plaeyade/Zumaya-AI/fuentes/blindaje_GAMMA/ESTIMACION_BLINDAJES_ONCOLOGIA_ZUMAYA.pdf

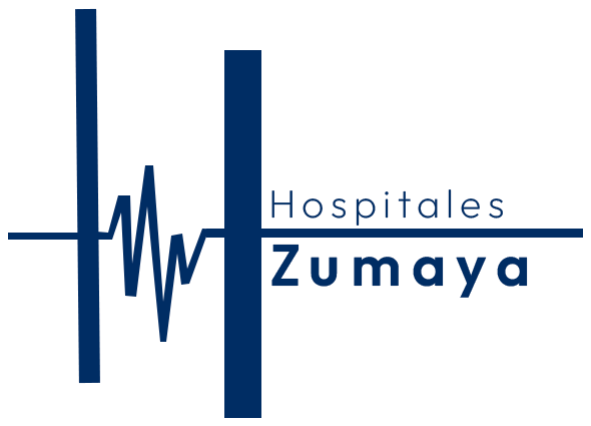
[picture p23: figure]

# ESTIMACIÓN DE BLINDAJES ONCOLOGÍA ZUMAYA

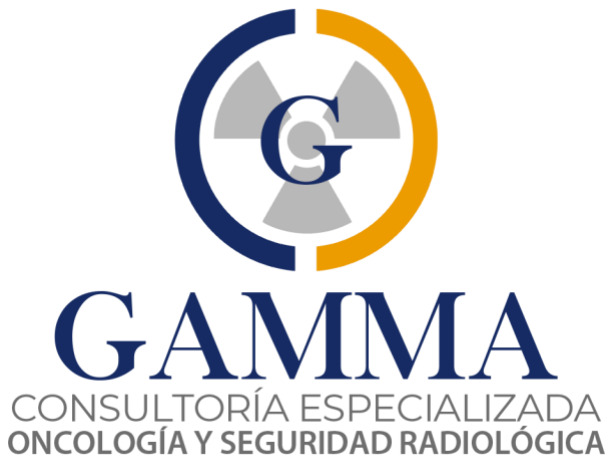
[picture p24: figure]

# HOSPITALES ZUMAYA VILLAHERMOSA

# CENTRO INTERNACIONAL DE NEURO-ONCOLOGÍA ZUMAYA

28/10/2026 LA INFORMACIÓN CONTENIDA EN ESTE DOCUMENTO ES ESTRICTAMENTE CONFIDENCIAL Y DE USO EXCLUSIVO DE GAMMA DIAGNÓSTICOS DEL SURESTE S.A. DE C.V. Y HOSPITALES ZUMAYA

# CONSIDERACIONES

- Se ha realizado un calculo estimado basado en guías y estándares internacionales utilizando un

# material de blindaje con densidad de 5.5 g/cm³

# , 5.0 g/cm³

# y 2.35 g/cm³ con el objetivo de

tener una comparación.

# - Se ha considerado la carga de trabajo máxima de los respectivos equipos contemplando el crecimiento en las mismas

- Se ha validado la propuesta de diseño del áreas, en el caso del acelerador lineal se ha dado

# prioridad a ganar espacio interno en la sala del acelerador

- Los espesores de los muros estimados en el presente documento son preliminares y el espesor final se definirá en la memoria analítica definitiva, la cual podrá presentar una variación de

# entre 15% y 20%

# Acelerador Lineal

# INFORMACIÓN DESTACADA

# - Paredes de concreto monolítico o tabiques

# - Estimaciones calculadas con densidad de 5.5 g/cm³

# , 5.0 g/cm³

# y 2.35 g/cm³

# - Criterios conservadores en los cálculos conforme a la NCRP151

# - 30 Pacientes por jornada de 8 horas

# - 2 Turnos semanales de lunes a viernes

# - 300cGy por paciente

# ECUACIONES

# - Factor de transmitancia de la barrera primaria

## - Bpri =

Pdpri

2

## WUT

# - Numero de capas decirreductoras

# - n = −log(Bpri)

# - Espesor de la barrera

# - tbarrier = TVL1 + (n − 1)TVLe

# Espesores Estimados

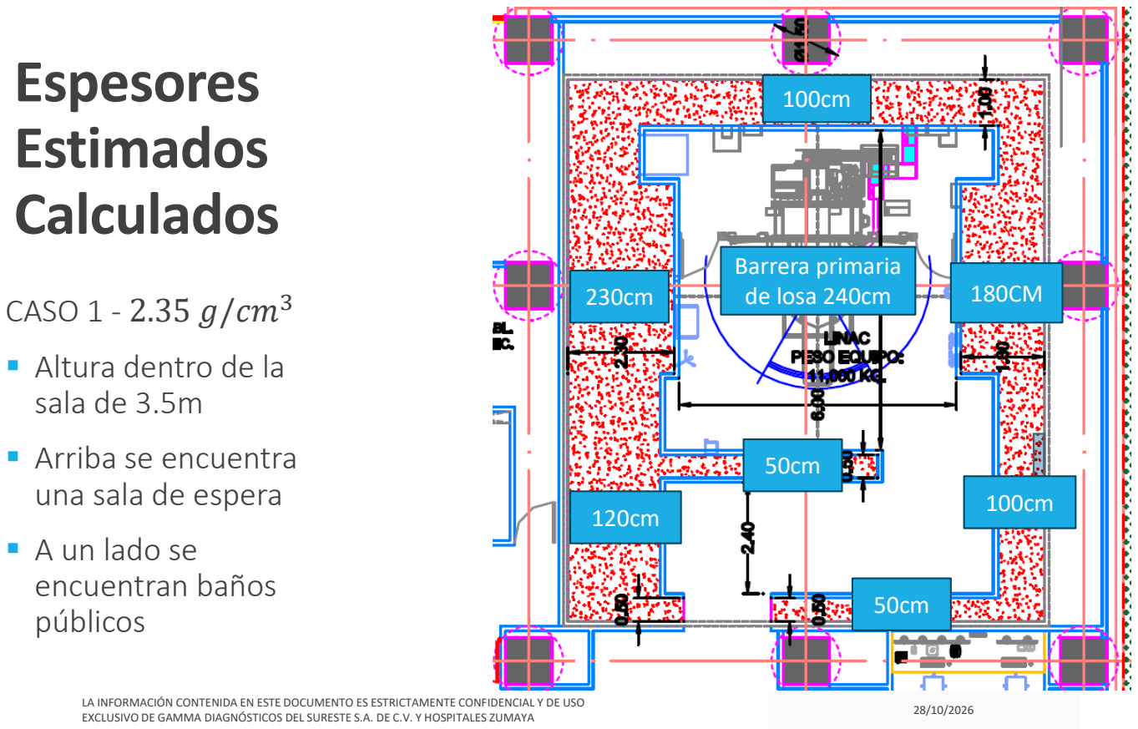
[picture p25: page 4]

# Calculados

# CASO 1 - 2.35 g/cm³

# - Altura dentro de la sala de 3.5m

# - Arriba se encuentra una sala de espera

# - A un lado se encuentran baños públicos

230cm | 180CM

# Barrera primaria de losa 240cm

100cm

50cm

50cm

120cm | 100cm

# Espesores Estimados

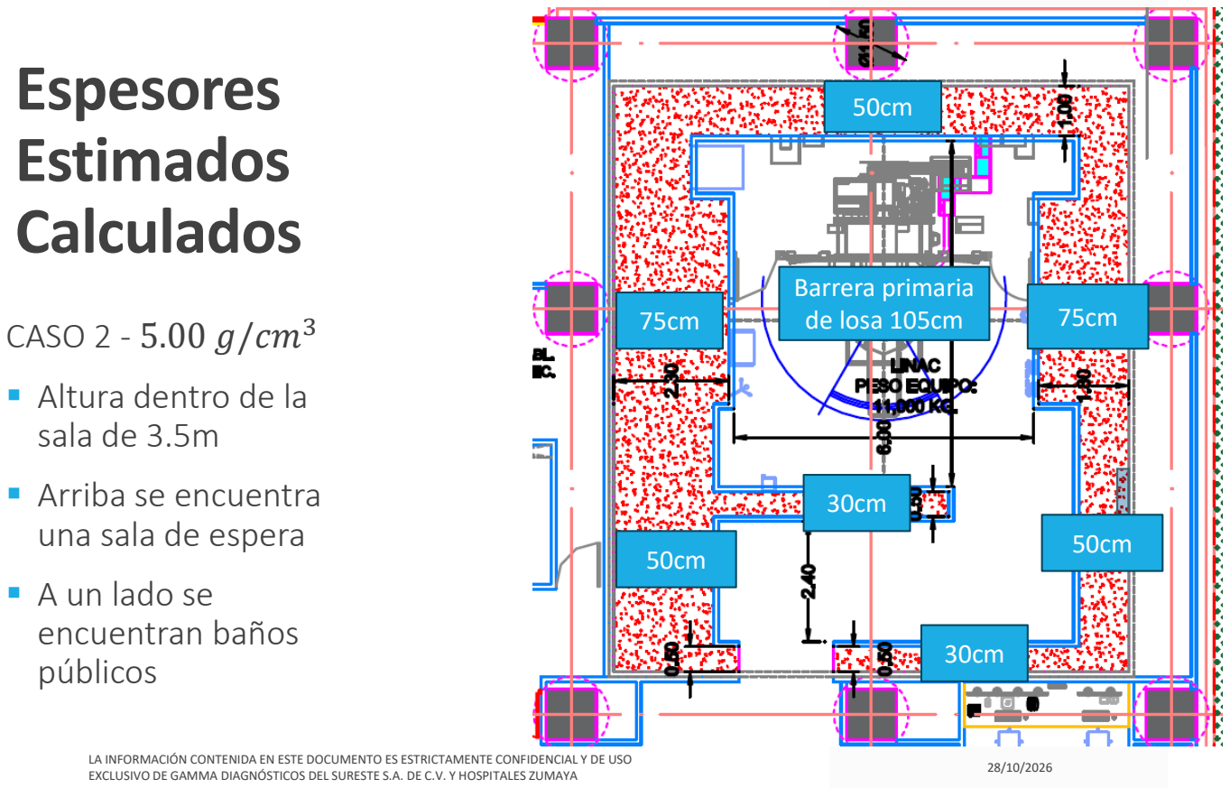
[picture p26: page 5]

# Calculados

# CASO 2 - 5.00 g/cm³

# - Altura dentro de la sala de 3.5m

# - Arriba se encuentra una sala de espera

# - A un lado se encuentran baños públicos

75cm | 75cm

# Barrera primaria de losa 105cm

50cm

30cm

30cm

50cm | 50cm

# Espesores Estimados

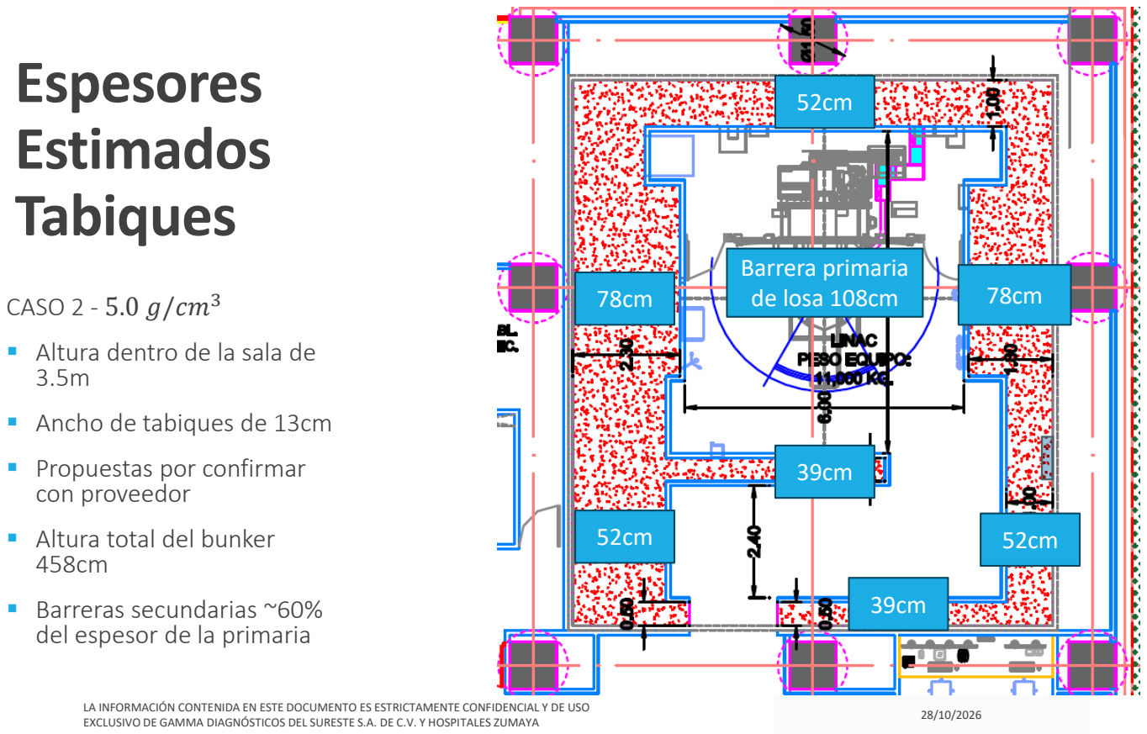
[picture p27: page 6]

# Tabiques

# CASO 2 - 5.0 g/cm³

# - Altura dentro de la sala de

3.5m

# - Ancho de tabiques de 13cm

# - Propuestas por confirmar con proveedor

# - Altura total del bunker

458cm

# - Barreras secundarias ~60% del espesor de la primaria

78cm | 78cm

# Barrera primaria de losa 108cm

52cm | 52cm

52cm

39cm

39cm

# Espesores Estimados

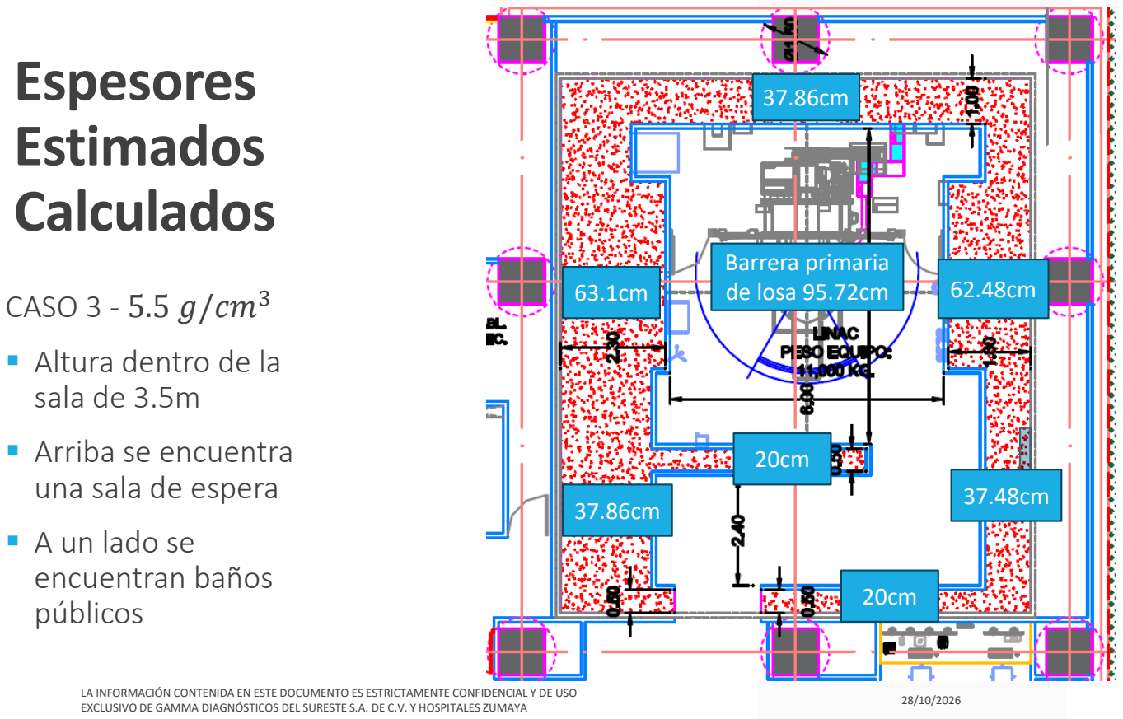
[picture p28: page 7]

# Calculados

# CASO 3 - 5.5 g/cm³

# - Altura dentro de la sala de 3.5m

# - Arriba se encuentra una sala de espera

# - A un lado se encuentran baños públicos

63.1cm | 62.48cm

# Barrera primaria de losa 95.72cm

37.86cm

20cm

20cm

37.86cm | 37.48cm

# Espesores Estimados

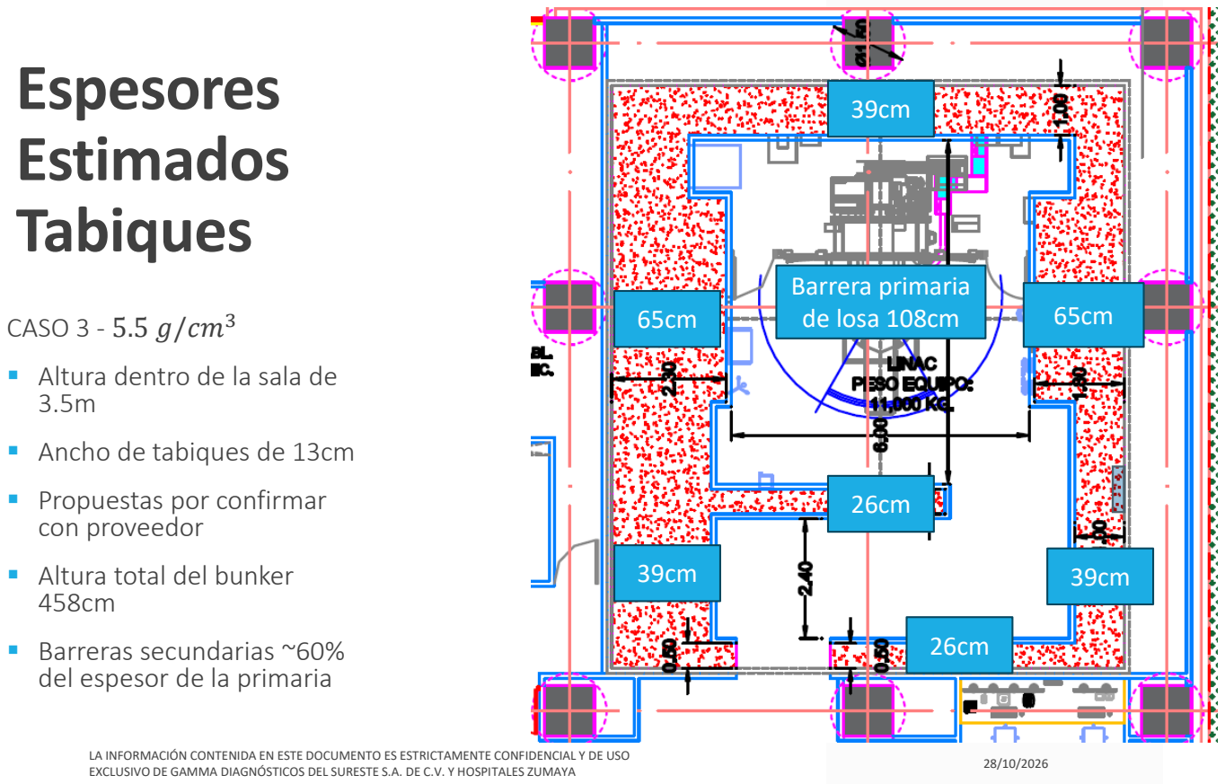
[picture p29: page 8]

# Tabiques

# CASO 3 - 5.5 g/cm³

# - Altura dentro de la sala de

3.5m

# - Ancho de tabiques de 13cm

# - Propuestas por confirmar con proveedor

# - Altura total del bunker

458cm

# - Barreras secundarias ~60% del espesor de la primaria

65cm | 65cm

# Barrera primaria de losa 108cm

39cm | 39cm

39cm

26cm

26cm

# Espesores Estimados

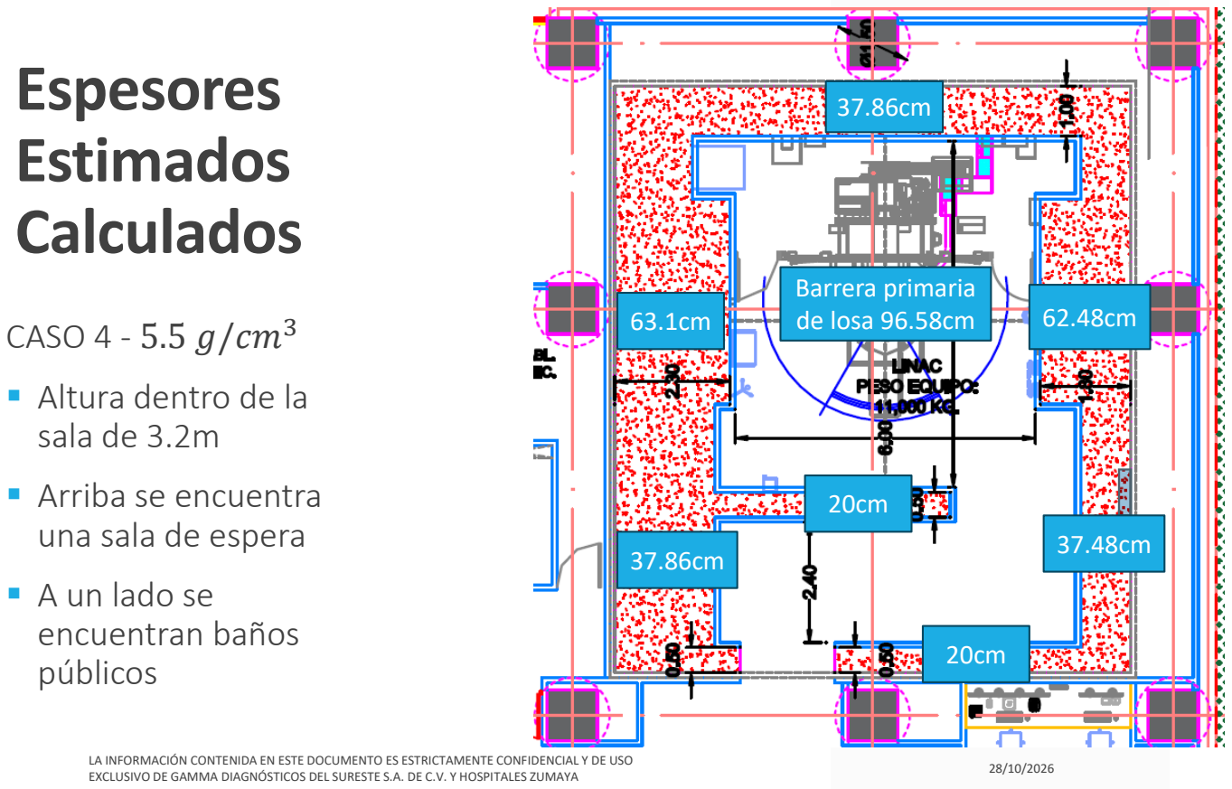
[picture p30: page 9]

# Calculados

# CASO 4 - 5.5 g/cm³

# - Altura dentro de la sala de 3.2m

# - Arriba se encuentra una sala de espera

# - A un lado se encuentran baños públicos

63.1cm | 62.48cm

# Barrera primaria de losa 96.58cm

37.86cm

20cm

20cm

37.86cm | 37.48cm

# Espesores Estimados

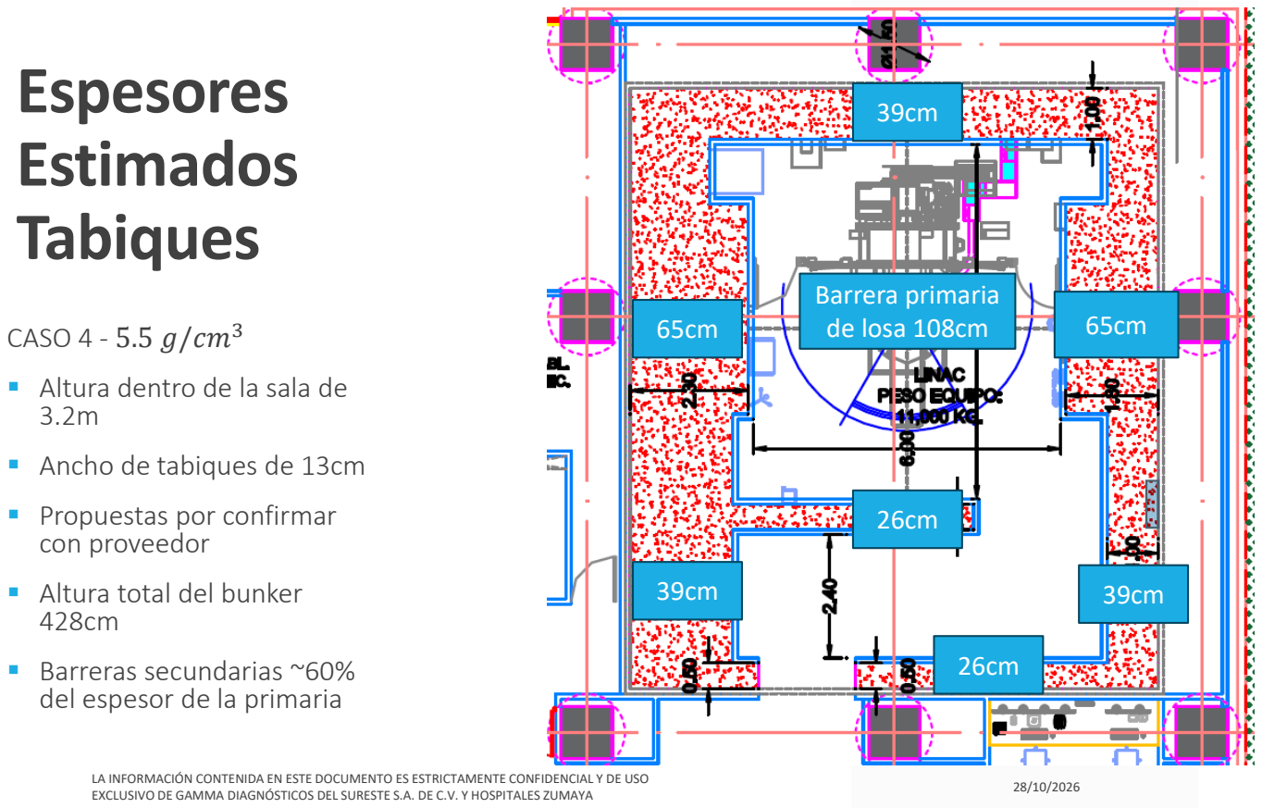
[picture p31: page 10]

# Tabiques

# CASO 4 - 5.5 g/cm³

# - Altura dentro de la sala de

3.2m

# - Ancho de tabiques de 13cm

# - Propuestas por confirmar con proveedor

# - Altura total del bunker

428cm

# - Barreras secundarias ~60% del espesor de la primaria

65cm | 65cm

# Barrera primaria de losa 108cm

39cm | 39cm

39cm

26cm

26cm

# Braquiterapia de Alta Tasa de Dosis

# INFORMACIÓN DESTACADA

# - Paredes de concreto monolítico o tabiques

# - Estimaciones calculadas con material de 3.5 g/cm³

# - Criterio restrictivo Safety Report No. 47

# - 40 ~ 50 Pacientes semanales

# - Tiempo promedio por tratamiento 25min

# - 7Gy por paciente

# ECUACIONES

# - Tasa de kerma e aire para una fuente por unidad de actividad

# - W = RAKR ∗ A ∗ t ∗ n

# - Numero de capas decirreductoras

# - No. de TVLs = −log10(

1
B

)

# - Espesor de la barrera

# - tbarrier = TVL1 + (n − 1)TVLe

# Espesores Estimados

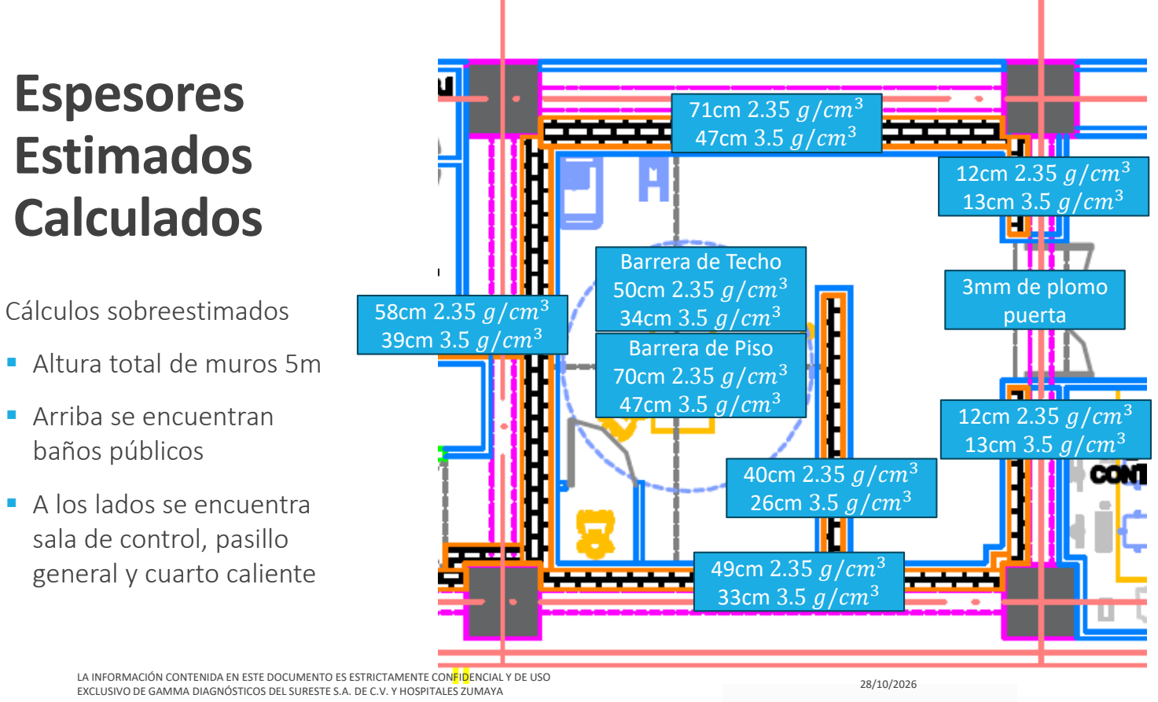
[picture p32: page 12]

# Calculados

# Cálculos sobreestimados

# - Altura total de muros 5m

# - Arriba se encuentran baños públicos

# - A los lados se encuentra sala de control, pasillo general y cuarto caliente

# 58cm 2.35 g/cm³ 39cm 3.5 g/cm³

# 3mm de plomo puerta

# 71cm 2.35 g/cm³ 47cm 3.5 g/cm³

# 49cm 2.35 g/cm³ 33cm 3.5 g/cm³

# 40cm 2.35 g/cm³ 26cm 3.5 g/cm³

# 12cm 2.35 g/cm³ 13cm 3.5 g/cm³

# Barrera de Techo 50cm 2.35 g/cm³ 34cm 3.5 g/cm³

# Barrera de Piso 70cm 2.35 g/cm³ 47cm 3.5 g/cm³

# 12cm 2.35 g/cm³ 13cm 3.5 g/cm³

# Espesores Estimados

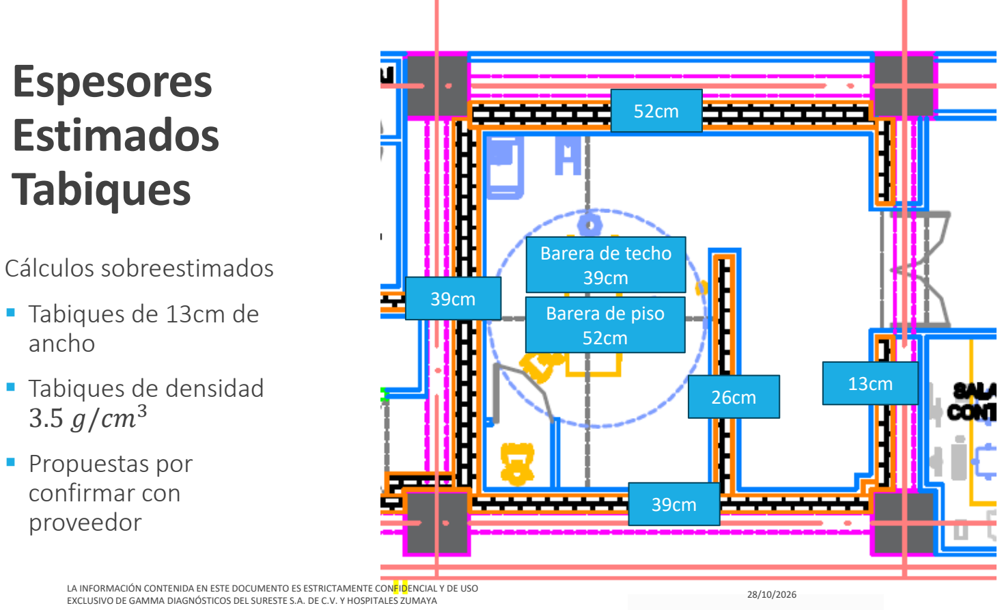
[picture p33: page 13]

# Tabiques

# Cálculos sobreestimados

# - Tabiques de 13cm de ancho

# - Tabiques de densidad 3.5 g/cm³

# - Propuestas por confirmar con proveedor

39cm

52cm

26cm

13cm

39cm

# Barera de techo

39cm

# Barera de piso

52cm

# Gamma Knife

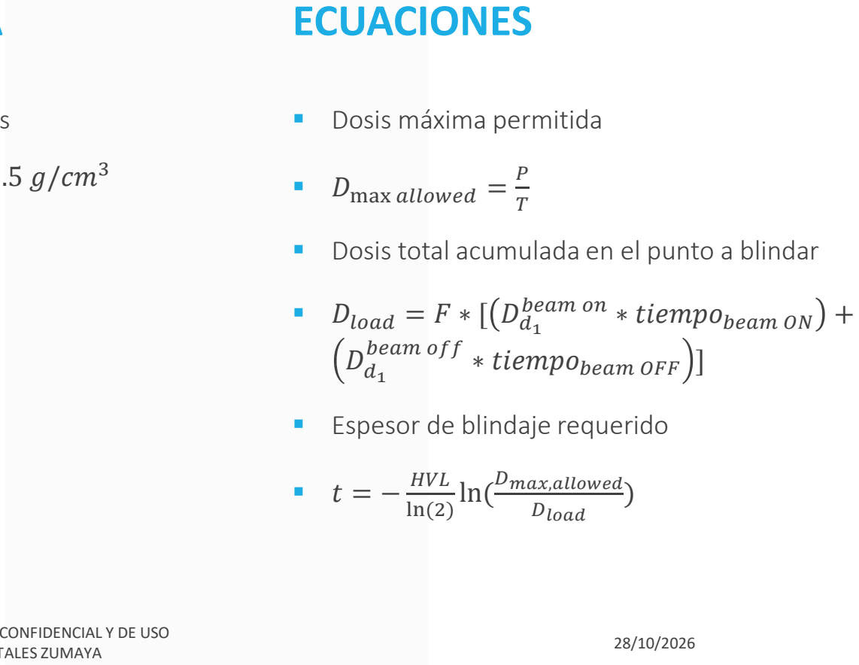
[picture p34: figure]
ECUACIONES; ▪ Dosis máxima permitida; ▪ Dmax allowed =; ▪ Dload = F ∗ [ Dd1; beam on ∗ tiempobeam ON +; beam off; ∗ tiempobeam OFF ]; ▪ Espesor de blindaje requerido; HVL ln(2); Dmax,allowed; Dload

# INFORMACIÓN DESTACADA

## - Paredes de concreto monolítico o tabiques

## - Estimaciones calculadas con material de 3.5 g/cm³

## - Criterio restrictivo ICRP

## - 20 Pacientes semanales

## - 5 días a la semana

## - Actividad máxima de 6600Ci +10%

## - Dosis total acumulada en el punto a blindar

# Espesores Estimados

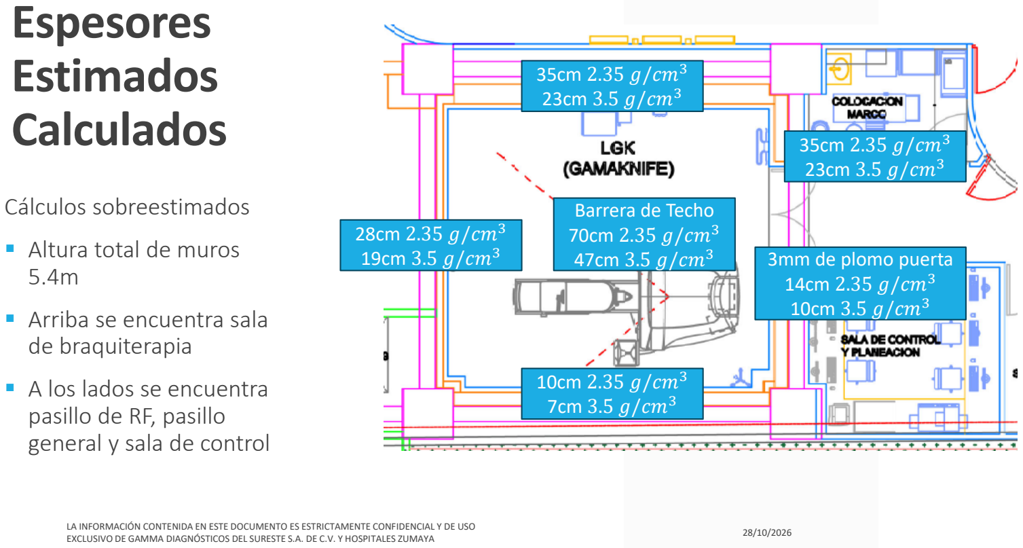
[picture p35: page 15]

# Calculados

# Cálculos sobreestimados

# - Altura total de muros

5.4m

# - Arriba se encuentra sala de braquiterapia

# - A los lados se encuentra pasillo de RF, pasillo general y sala de control

# 28cm 2.35 g/cm³ 19cm 3.5 g/cm³

# 10cm 2.35 g/cm³ 7cm 3.5 g/cm³

# 35cm 2.35 g/cm³ 23cm 3.5 g/cm³

# 3mm de plomo puerta 14cm 2.35 g/cm³ 10cm 3.5 g/cm³

# Barrera de Techo 70cm 2.35 g/cm³ 47cm 3.5 g/cm³

# 35cm 2.35 g/cm³ 23cm 3.5 g/cm³

# PET/CT

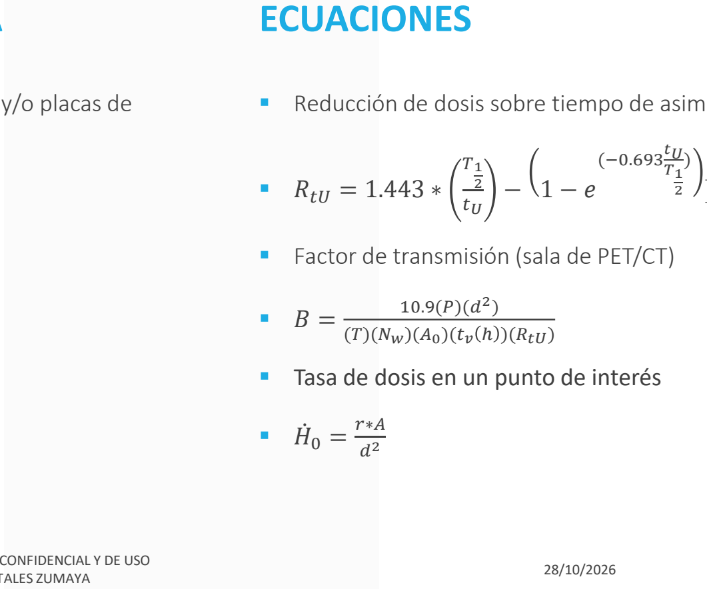
[picture p36: figure]
ECUACIONES; ▪ RtU = 1.443 ∗; (T)(Nw)(A0)(tv ℎ )(RtU); ▪ Tasa de dosis en un punto de interés

# INFORMACIÓN DESTACADA

## - Paredes de concreto monolítico, tabiques y/o placas de plomo

## - Criterio restrictivo AAPM Task Group 108

## - 60 Pacientes por semana, 2 turnos al día

## - 5 días a la semana

## - Actividad por paciente de 20mCi

## - Reducción de dosis sobre tiempo de asimilación de dosis

]

## - Factor de transmisión (sala de PET/CT)

# Espesores Estimados

# Cálculos sobreestimados - Altura de entrepiso 5m - Arriba se encuentra Medicina Nuclear - A los lados se encuentra sala de control y salas de inyección - Solo es necesario blindar hasta 2.5m de altura

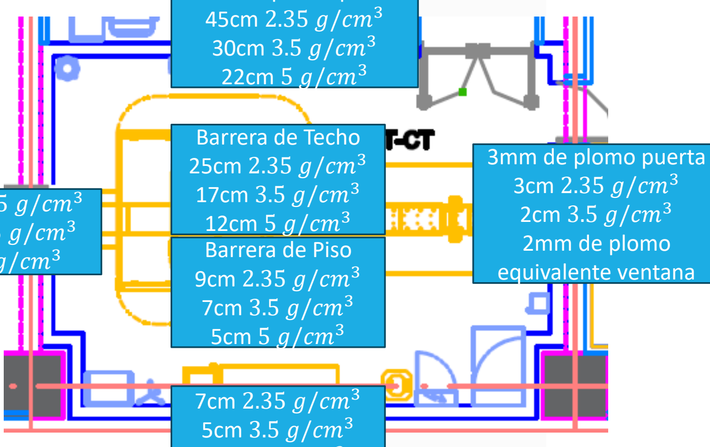
[picture p37: figure]
45cm 2.35 g/cm³ 30cm 3.5 g/cm³ 22cm 5 g/cm³; 3mm de plomo puerta 3cm 2.35 g/cm³ 2cm 3.5 g/cm³ 2mm de plomo equivalente ventana; 7cm 2.35 g/cm³ 5cm 3.5 g/cm³

# 15cm 2.35 g/cm³ 10cm 3.5 g/cm³ 7cm 5 g/cm³

# 3mm de plomo puerta

# Barrera de Techo 25cm 2.35 g/cm³ 17cm 3.5 g/cm³ 12cm 5 g/cm³

# Barrera de Piso 9cm 2.35 g/cm³ 7cm 3.5 g/cm³ 5cm 5 g/cm³

# 4cm 5 g/cm³

# Espesores

# Barrera de Techo

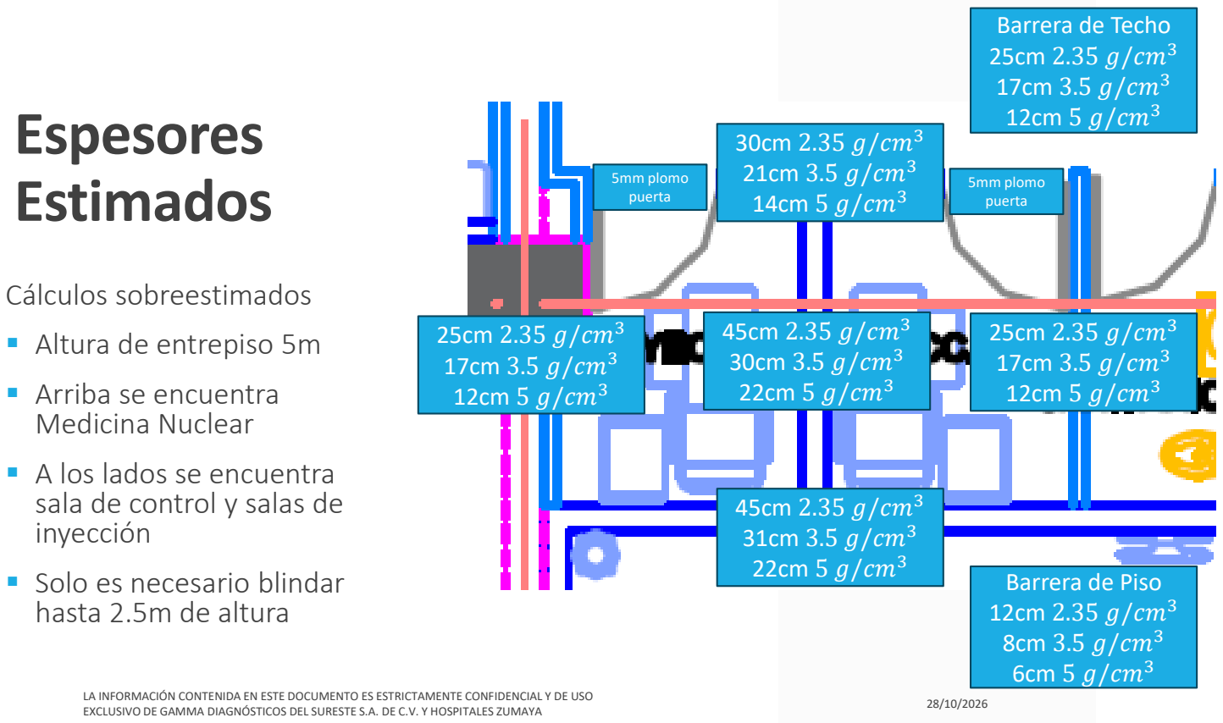
[picture p38: page 18]

# Estimados

# Cálculos sobreestimados - Altura de entrepiso 5m - Arriba se encuentra Medicina Nuclear - A los lados se encuentra sala de control y salas de inyección - Solo es necesario blindar hasta 2.5m de altura

### 5mm plomo puerta

# 25cm 2.35 g/cm³ 17cm 3.5 g/cm³ 12cm 5 g/cm³

# 25cm 2.35 g/cm³ 17cm 3.5 g/cm³ 12cm 5 g/cm³

# 45cm 2.35 g/cm³ 30cm 3.5 g/cm³ 22cm 5 g/cm³

# 25cm 2.35 g/cm³ 17cm 3.5 g/cm³ 12cm 5 g/cm³

# 30cm 2.35 g/cm³ 21cm 3.5 g/cm³ 14cm 5 g/cm³

### 5mm plomo puerta

# Barrera de Piso 12cm 2.35 g/cm³ 8cm 3.5 g/cm³ 6cm 5 g/cm³

# 45cm 2.35 g/cm³ 31cm 3.5 g/cm³ 22cm 5 g/cm³

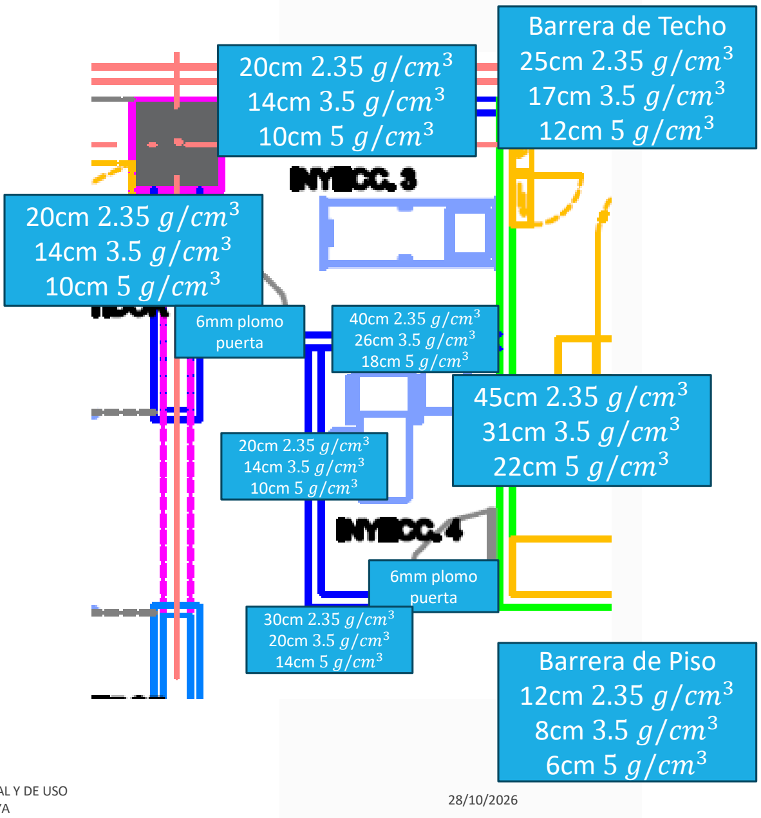
[picture p39: figure]
20cm 2.35 g/cm³ 14cm 3.5 g/cm³ 10cm 5 g/cm³; Barrera de Techo 25cm 2.35 g/cm³ 17cm 3.5 g/cm³ 12cm 5 g/cm³; 6mm plomo puerta; Barrera de Piso 12cm 2.35 g/cm³ 8cm 3.5 g/cm³ 6cm 5 g/cm³; 40cm 2.35 g/cm³ 26cm 3.5 g/cm³ 18cm 5 g/cm³; 30cm 2.35 g/cm³ 20cm 3.5 g/cm³ 14cm 5 g/cm³; 45cm 2.35 g/cm³ 31cm 3.5 g/cm³ 22cm 5 g/cm³

# Espesores Estimados

# Cálculos sobreestimados - Altura de entrepiso 5m - Arriba se encuentra Medicina Nuclear - A los lados se encuentra sala de control y salas de inyección - Solo es necesario blindar hasta 2.5m de altura

# Espesores

# CASTILLO DE 5CM DE

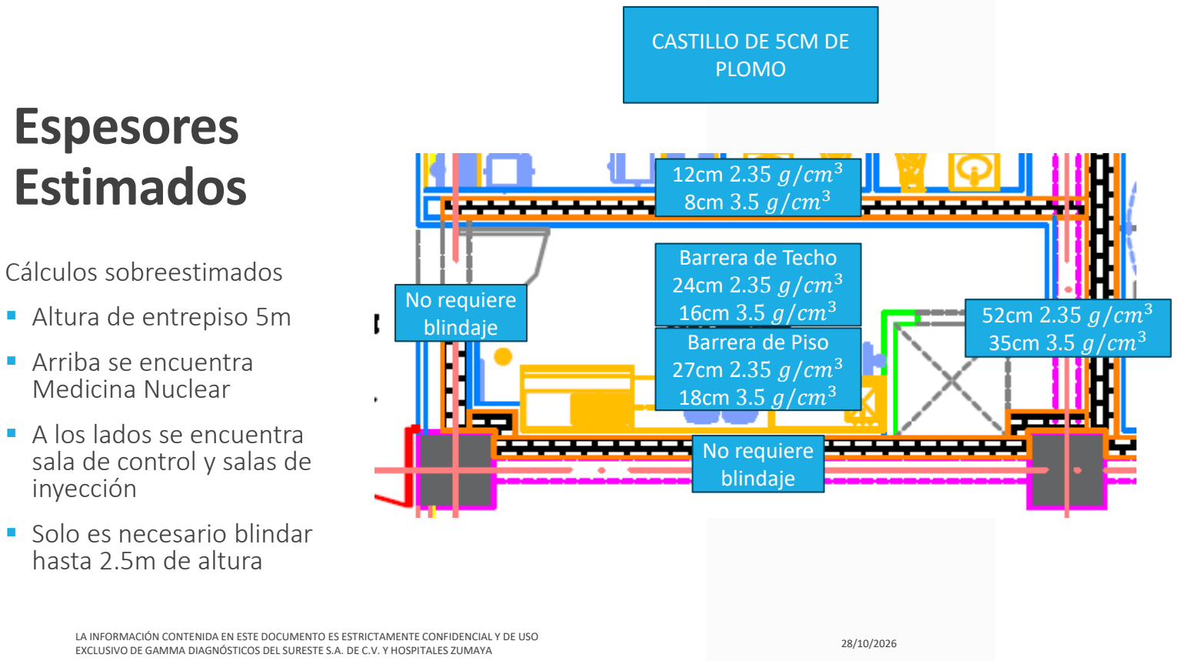
[picture p40: page 20]

# Estimados

# Cálculos sobreestimados - Altura de entrepiso 5m - Arriba se encuentra Medicina Nuclear - A los lados se encuentra sala de control y salas de inyección - Solo es necesario blindar hasta 2.5m de altura

# No requiere blindaje

# PLOMO

# 12cm 2.35 g/cm³ 8cm 3.5 g/cm³

# Barrera de Techo 24cm 2.35 g/cm³ 16cm 3.5 g/cm³

# Barrera de Piso 27cm 2.35 g/cm³ 18cm 3.5 g/cm³

# No requiere

blindaje | 52cm 2.35 g/cm³
| 35cm 3.5 g/cm³

# SPECT/CT

# INFORMACIÓN DESTACADA

## - Paredes de concreto monolítico, tabiques y/o placas de plomo

## - Criterio restrictivo IAEA-TECODC-1608

## - 40 Pacientes por semana Tc99, 2 pacientes de I131, 1 paciente de Lu-177

## - 5 días a la semana

## - Actividad variable por paciente y por estudio, se consideran los tiempos de estancia variables por isotopo

# ECUACIONES

## - Reducción de dosis sobre tiempo de asimilación de dosis

## - RtU = 1.443 ∗

T1
2
tU

− 1 − e

(−0.693tU
T1
2

)
]

## - Factor de transmisión

- B =

P

### ሶ Hሶ

0

## - Tasa equivalente de dosis con blindaje

- Hሶ

## f = Hሶ

0e

−μx

# Espesores

# 2mm Plomo

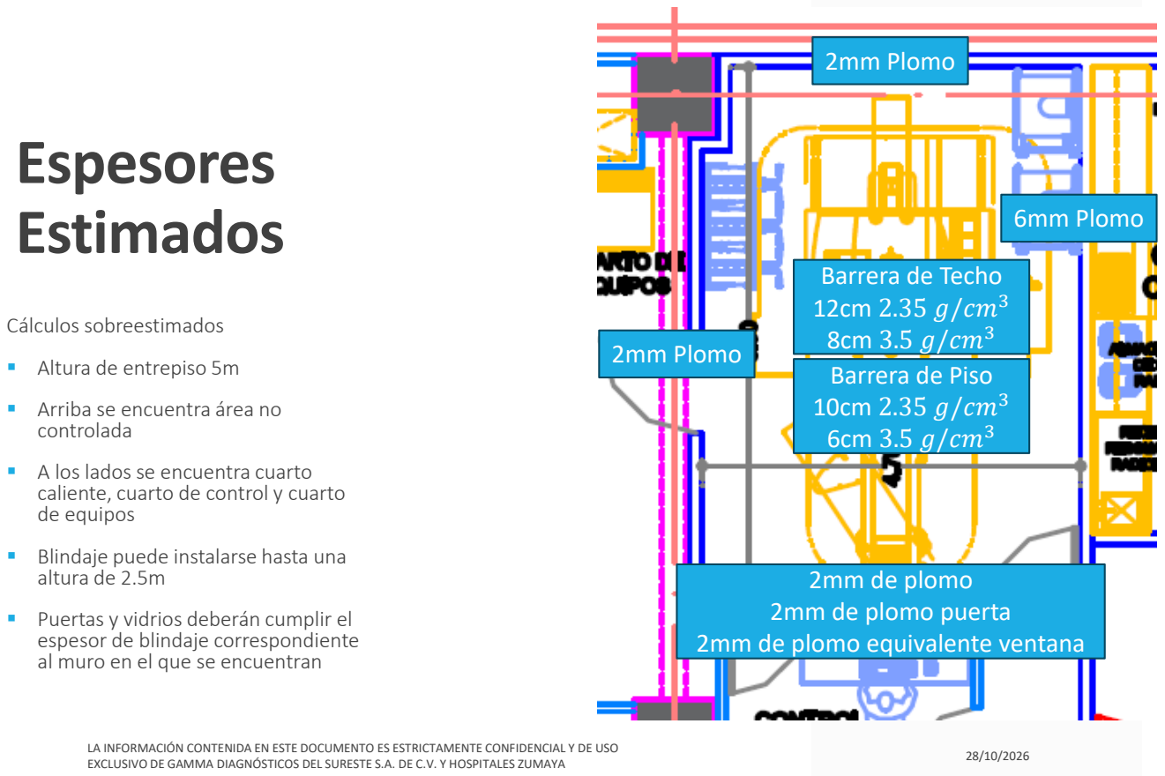
[picture p41: page 22]

# Estimados

## Cálculos sobreestimados

## - Altura de entrepiso 5m

## - Arriba se encuentra área no controlada

## - A los lados se encuentra cuarto caliente, cuarto de control y cuarto de equipos

## - Blindaje puede instalarse hasta una altura de 2.5m

## - Puertas y vidrios deberán cumplir el espesor de blindaje correspondiente al muro en el que se encuentran

# 2mm Plomo

# Barrera de Techo 12cm 2.35 g/cm³ 8cm 3.5 g/cm³

# Barrera de Piso 10cm 2.35 g/cm³ 6cm 3.5 g/cm³

# 6mm Plomo

# 2mm de plomo 2mm de plomo puerta 2mm de plomo equivalente ventana

# Espesores Estimados

## Cálculos sobreestimados

## - Altura de entrepiso 5m

## - Arriba se encuentra área no controlada

## - A los lados se encuentra cuarto caliente, cuarto de control y cuarto de equipos

## - Blindaje puede instalarse hasta una altura de 2.5m

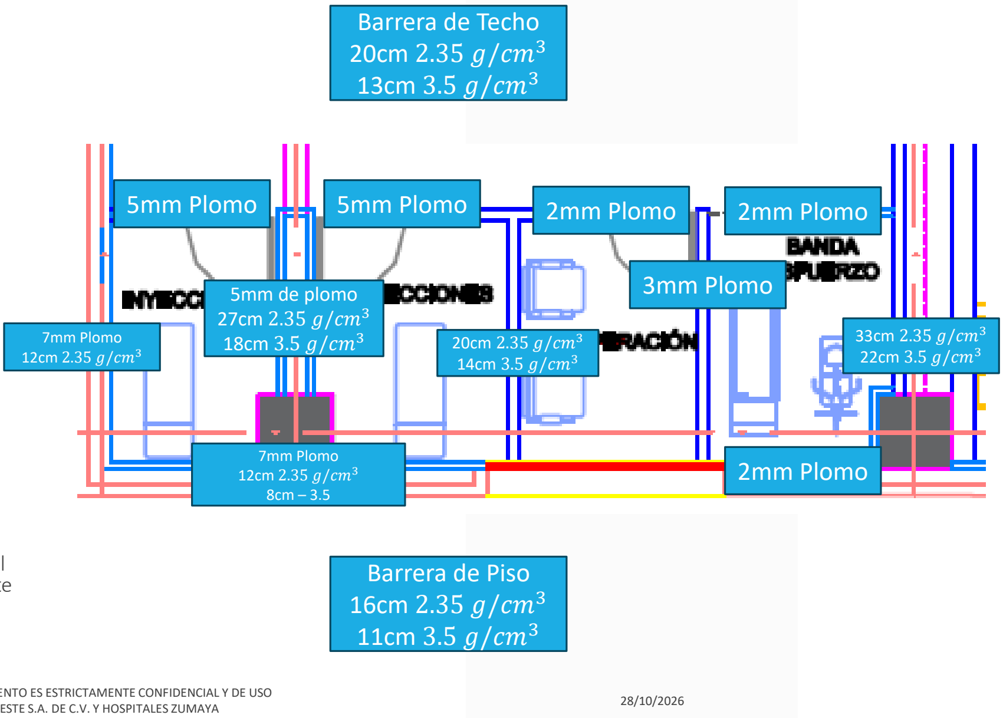
[picture p42: figure]
7mm Plomo 12cm 2.35 g/cm³; 7mm Plomo 12cm 2.35 g/cm³ 8cm – 3.5; 20cm 2.35 g/cm³ 14cm 3.5 g/cm³; Barrera de Techo 20cm 2.35 g/cm³ 13cm 3.5 g/cm³; Barrera de Piso 16cm 2.35 g/cm³ 11cm 3.5 g/cm³; 5mm de plomo 27cm 2.35 g/cm³ 18cm 3.5 g/cm³; 2mm Plomo; 3mm Plomo; 33cm 2.35 g/cm³ 22cm 3.5 g/cm³; 5mm Plomo

## - Puertas y vidrios deberán cumplir el espesor de blindaje correspondiente al muro en el que se encuentran

# Espesores

# Pendiente calculo de

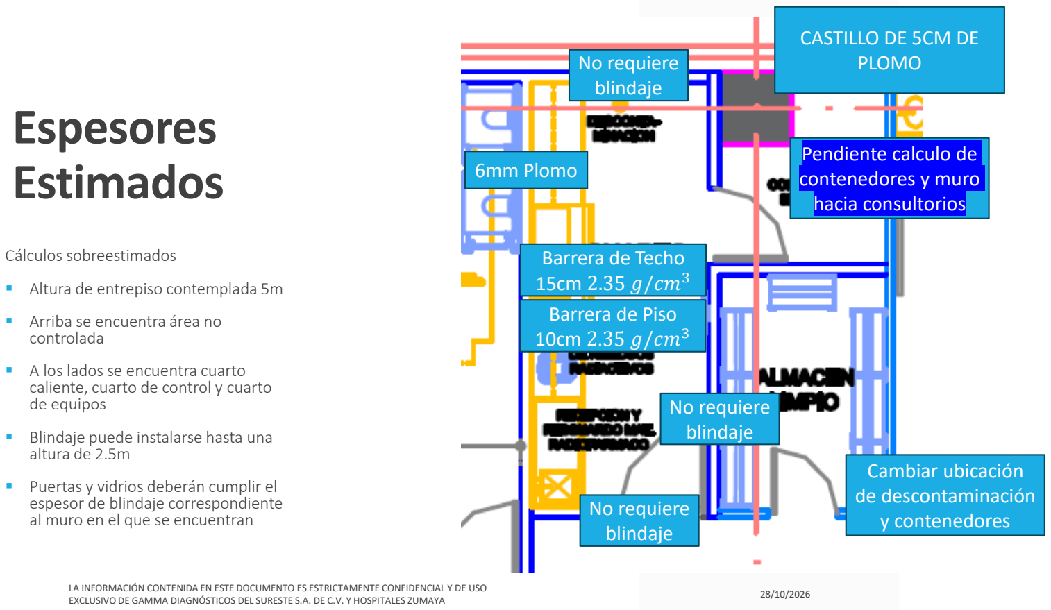
[picture p43: page 24]

# Estimados

## Cálculos sobreestimados

## - Altura de entrepiso contemplada 5m

## - Arriba se encuentra área no controlada

## - A los lados se encuentra cuarto caliente, cuarto de control y cuarto de equipos

## - Blindaje puede instalarse hasta una altura de 2.5m

## - Puertas y vidrios deberán cumplir el espesor de blindaje correspondiente al muro en el que se encuentran

# Cambiar ubicación de descontaminación y contenedores

# contenedores y muro hacia consultorios

# Barrera de Techo 15cm 2.35 g/cm³

# CASTILLO DE 5CM DE

No requiere | PLOMO

# blindaje

# No requiere blindaje

# No requiere blindaje

# Barrera de Piso 10cm 2.35 g/cm³

# 6mm Plomo

# Medicina Nuclear

# INFORMACIÓN DESTACADA

## - Paredes de concreto monolítico, tabiques y/o placas de plomo

## - Criterio restrictivo IAEA-TECODC-1608

## - Carga máxima semanal de 2 pacientes cada uno 3 días hospitalizado

## - Dosis máxima administrada de 200mCi de I131

# ECUACIONES

## - Reducción de dosis sobre tiempo de asimilación de dosis

## - RtU = 1.443 ∗

T1
2
tU

− 1 − e

(−0.693tU
T1
2

)
]

## - Factor de transmisión

- B =

P

### ሶ Hሶ

0

## - Tasa equivalente de dosis con blindaje

- Hሶ

## f = Hሶ

0e

−μx

# Espesores

# 27cm 2.35 g/cm³

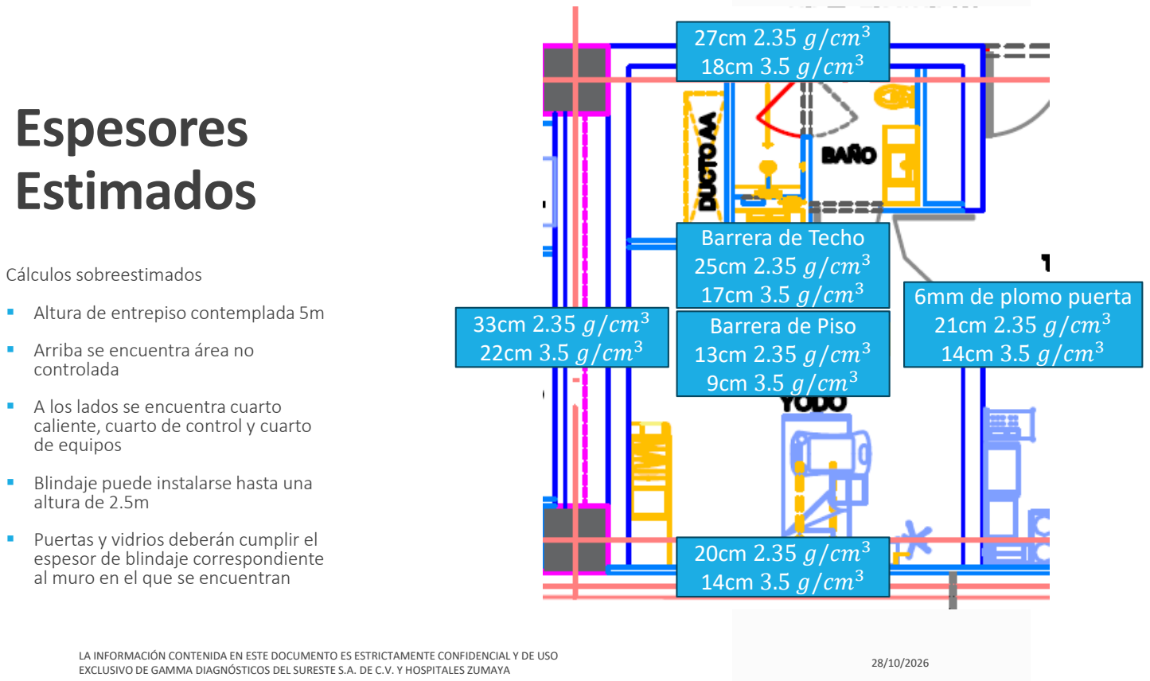
[picture p44: page 26]

# Estimados

## Cálculos sobreestimados

## - Altura de entrepiso contemplada 5m

## - Arriba se encuentra área no controlada

## - A los lados se encuentra cuarto caliente, cuarto de control y cuarto de equipos

## - Blindaje puede instalarse hasta una altura de 2.5m

## - Puertas y vidrios deberán cumplir el espesor de blindaje correspondiente al muro en el que se encuentran

# 33cm 2.35 g/cm³ 22cm 3.5 g/cm³

# Barrera de Techo 25cm 2.35 g/cm³ 17cm 3.5 g/cm³

# Barrera de Piso 13cm 2.35 g/cm³ 9cm 3.5 g/cm³

# 20cm 2.35 g/cm³ 14cm 3.5 g/cm³

# 18cm 3.5 g/cm³

# 6mm de plomo puerta 21cm 2.35 g/cm³ 14cm 3.5 g/cm³
