plaeyade/Zumaya-AI/informes/Seguimiento_Zumaya_31-10-26.xlsx

Sheet: Pasos Claude
Próximos pasos — ciclotrón Zumaya (31/10/2026)
Estado en amarillo: elige de la lista. Estimado total 1–2 h, según los lotes del Monte Carlo.
# | Paso | Detalle | Depende de | Estado
1 | Terminar lotes MC doble haz | Techo (2 lotes), sur (1) y oeste (2); muro este ya validado: 2.08 m de tabique 2.5 | Cómputo en curso | En curso
2 | Espesores por cara | Techo, oeste y sur con doble haz 2×150 µA, concreto 2.35 → tabique 2.5 por masa | Paso 1 | Pendiente
3 | Informe Zumaya | Completar secciones de validación contra IBA tabla 9 y doble haz | Paso 2 | Pendiente
4 | Bajada de cargas | Recalcular peso del búnker y pilas con los espesores nuevos | Paso 2 | Pendiente
5 | PDF y repos | Exportar PDF nuevo; subir a Zumaya-AI y Cyclotron-SIM | Pasos 3–4 | Pendiente
Avance | 0 de 5

Sheet: Datos pendientes
Datos que dependen de ti
Ordenados por impacto. Responsable y fecha: llénalos tú (ejemplo en la fila 1).
# | Dato | Para qué | Impacto | Responsable | Fecha compromiso | Estado
1 | Análisis químico del TD-250 | Repetir el MC del ciclotrón con el hidrógeno real (mientras: dos hipótesis, 1 % y 0.4 % H) | Alto | Proveedor CONTUPLEX |  | En proceso
2 | Pesaje de 5–10 piezas TD-550 | Saber si el linac necesita 1–2 o 3–4 tabiques más por muro (23.6 kg = 5.5; 18.4 kg = 4.29) | Alto
3 | Actividad real Co-60 Flexitron + geometría de su puerta | La puerta de GAMMA (3 mm Pb) casi no atenúa Co-60 | Alto
4 | Geometría de puerta y laberinto del linac | Fotoneutrones y gammas de captura a 15 MV | Alto
5 | Documentos IBA pendientes | Reporte de blindaje MC estándar/personalizado y asignación de blancos por puerto | Medio
6 | Layout de radiofarmacia | Celdas calientes, líneas de transferencia y su paso bajo el contraventeo NA | Medio
Avance | 0 de 6

Sheet: Decisiones
Decisiones tuyas
Marca la decisión en la columna Estado.
# | Decisión | Qué implica | Esfuerzo | Estado
1 | Combinar el PR de radiopharma-os | F81–F85 + F90 (contrato con Cyclotron-SIM y presupuesto de blindaje) a master | Revisión | Pendiente
2 | Arrancar etapa 0 de RadShieldMx | Rama aparte: quitar diálogos con resultados aleatorios, leyenda 'no válido para firma', lockfile contra npmjs, quitar aval institucional falso. No cambia el cálculo | 1 semana | Pendiente
3 | Acelerar el MC del ciclotrón | Agregar ventanas de peso para corridas más rápidas y estables (TD-250 real, otras máquinas) | 1–2 días | Pendiente
Avance | 0 de 3
