plaeyade/Zumaya-AI/informes/Linac_TD550_cumplimiento.xlsx

Sheet: Supuestos
Supuestos — linac Versa HD 15 MV, tabique TD-550 (CONTUPLEX)
Celdas en azul = entradas editables; amarillo = la incógnita que se resuelve pesando piezas en obra.
Parámetro | Valor | Unidad | Origen
Carga de trabajo W | 900 | Gy/sem | 30 pac × 2 turnos × 5 d × 3 Gy (estimación GAMMA, NCRP 151)
Límite de diseño P (público) | 2e-05 | Sv/sem | 0.02 mSv/sem (NCRP 151)
Fracción de fuga (90°) | 0.001 | — | NCRP 151: 0.1 % del haz útil
Módulo de tabique | 13 | cm | pieza 130 mm
TVL primaria TD-550, ficha (15 MV) | 18.2 | cm | ficha CONTUPLEX TD-550 (escalada por densidad nominal 5.5)
TVL fuga TD-550, ficha (15 MV) | 17.1 | cm | ficha CONTUPLEX TD-550
TVL primaria TD-350 medida (15 MV) | 28.7 | cm | ficha TD-350 (6/10 MV medidas; 15 MV interpolada)
TVL fuga TD-350 (15 MV) | 26.8 | cm | ficha TD-350
Densidad real TD-350 | 3.317 | g/cm³ | IMCYC OT-521, masa específica seca
Densidad real TD-550 (si no es 5.5) | 4.29 | g/cm³ | estimada 5.5 × (seca/aparente del '5' IMCYC) — sin ensaye
TVL primaria TD-550 con densidad real | 22.2 | cm | TVL TD-350 × ρ350 / ρ550 real
TVL fuga TD-550 con densidad real | 20.7 | cm | TVL TD-350 × ρ350 / ρ550 real
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
