plaeyade/Zumaya-AI/analisis_plano/losas_ciclotron.png

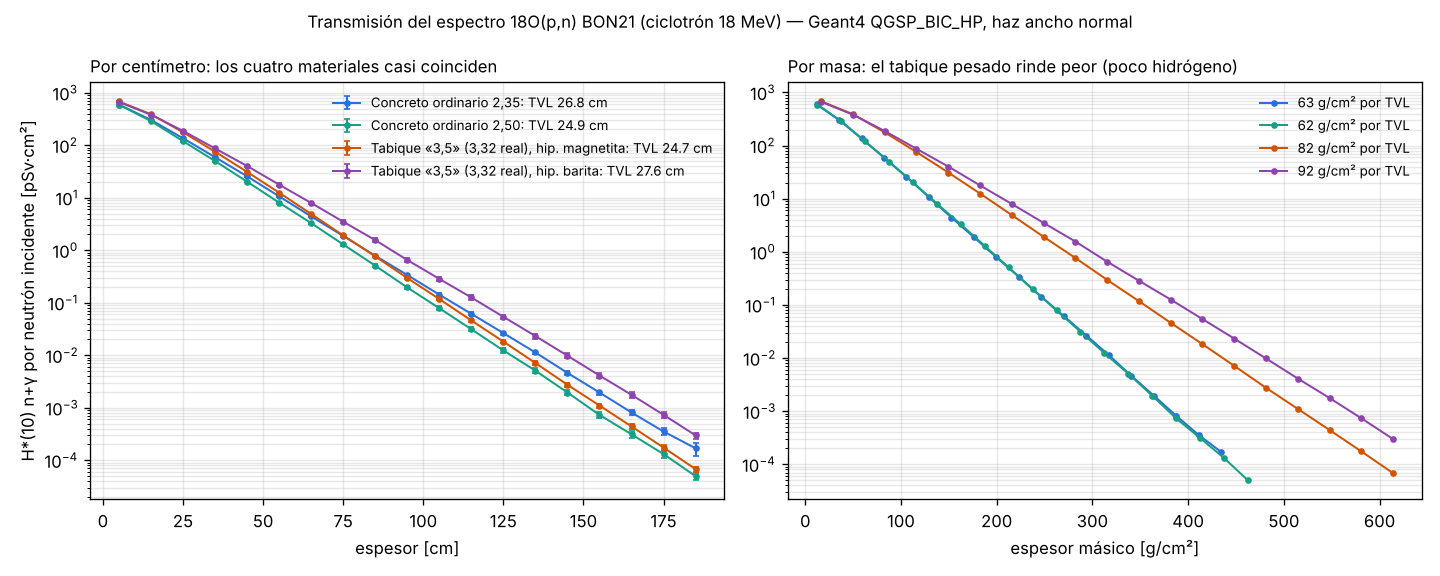
analisis_plano/losas_ciclotron.png
