plaeyade/Zumaya-AI/analisis_plano/pb_contraventeos.png

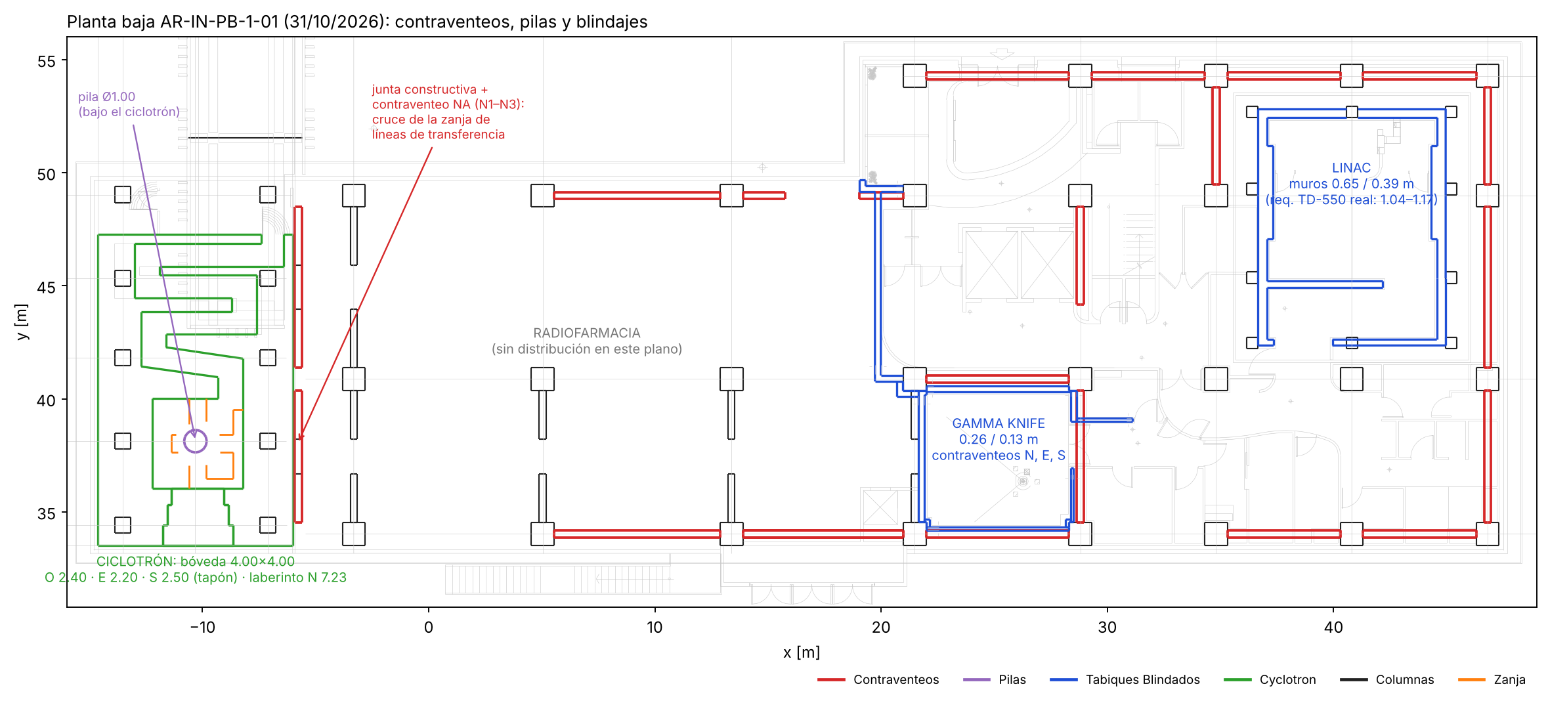
analisis_plano/pb_contraventeos.png
