plaeyade/Zumaya-AI/analisis_plano/pisos_blindajes.png

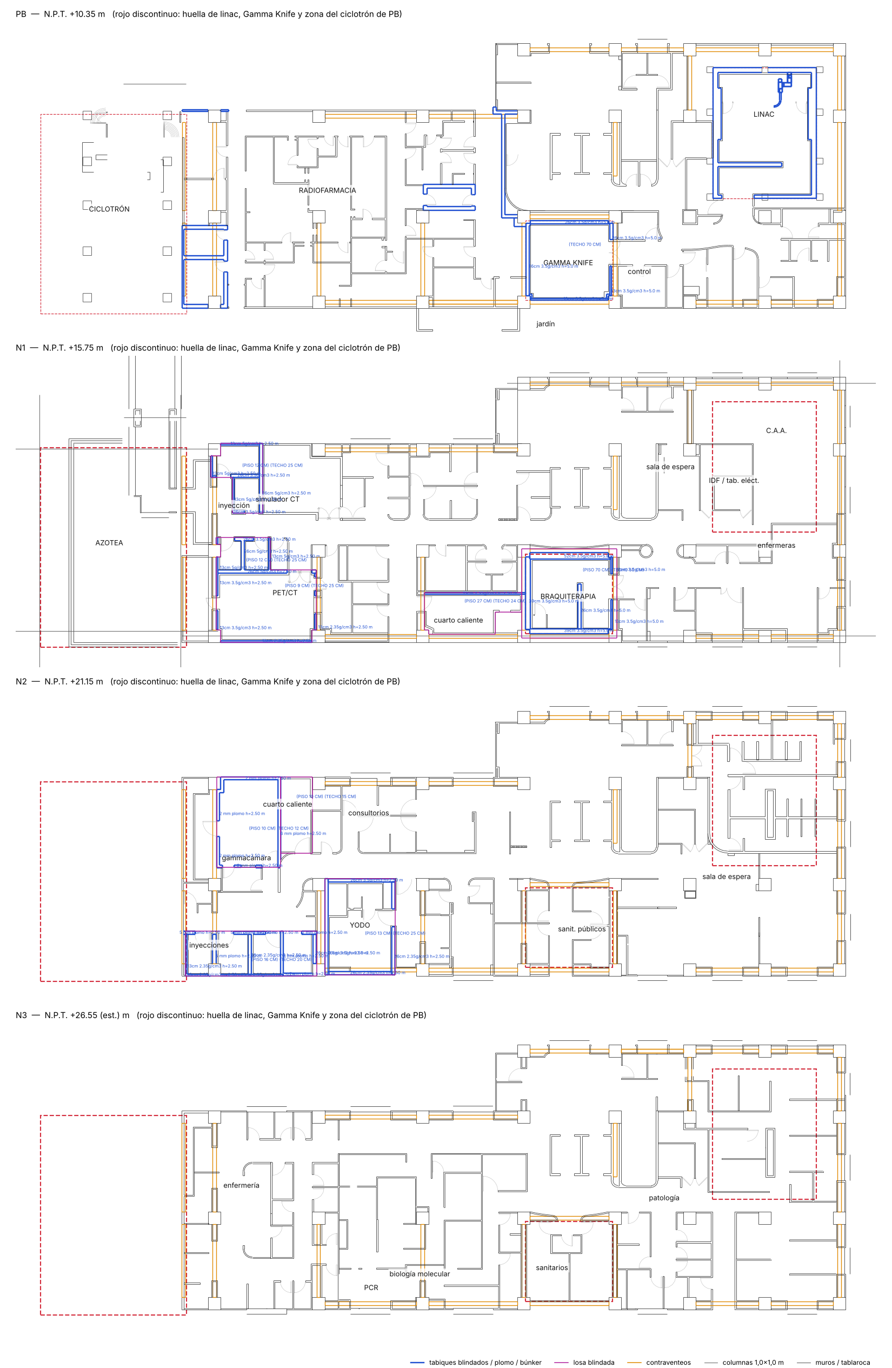
analisis_plano/pisos_blindajes.png
