plaeyade/Zumaya-AI/(list of files, cad)

Other CAD files:
fuentes/planos/PLANTA_BAJA_ARQ_31-10-26.dwg
fuentes/planos/PLANTAS_ARQ_BIND_28-10-26.dwg
