plaeyade/Zumaya-AI/operacion/resultados/curvas_disponibilidad_E1_inicial.png

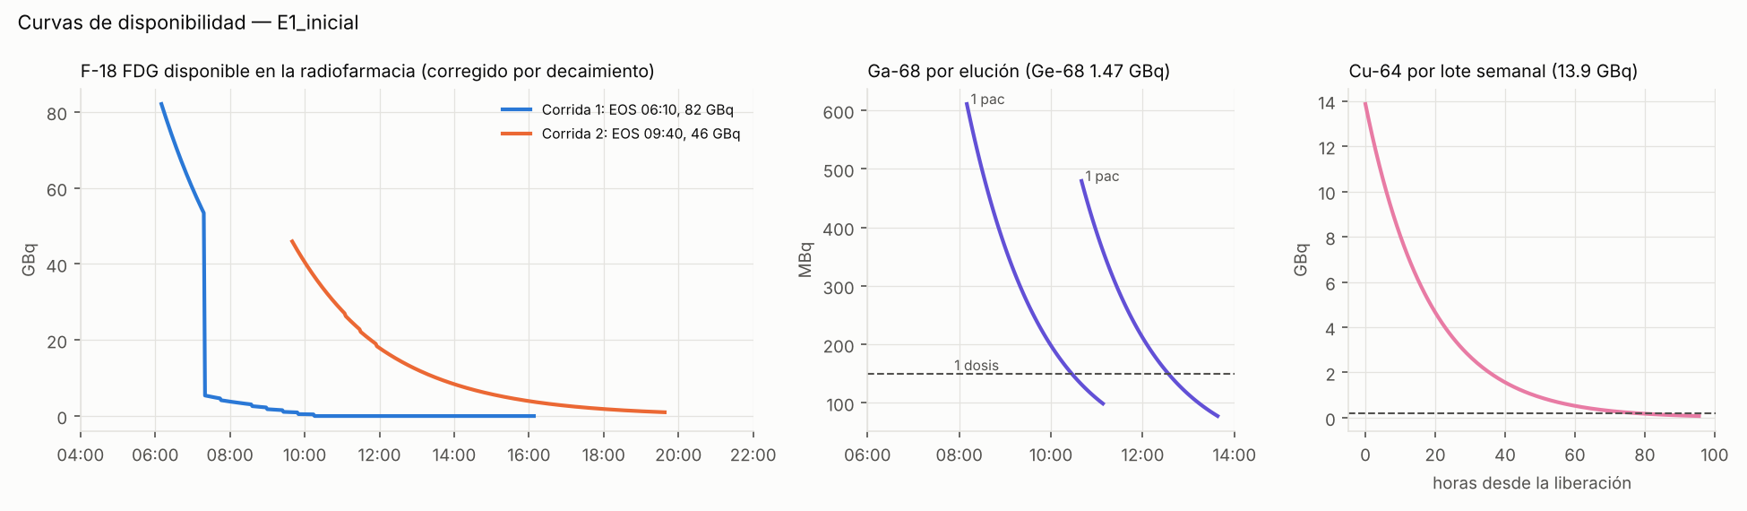
operacion/resultados/curvas_disponibilidad_E1_inicial.png
