plaeyade/Zumaya-AI/operacion/resultados/curvas_disponibilidad_E3_maximo.png

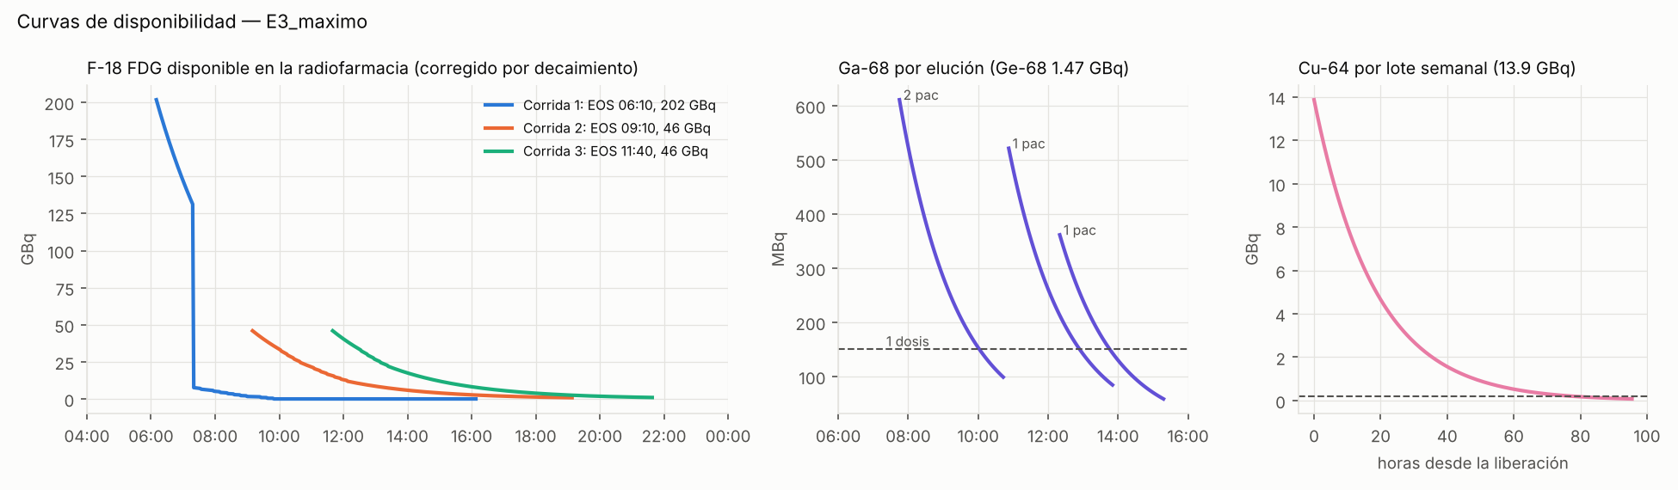
operacion/resultados/curvas_disponibilidad_E3_maximo.png
