plaeyade/Zumaya-AI/operacion/resultados/gantt_produccion_E1_inicial.png

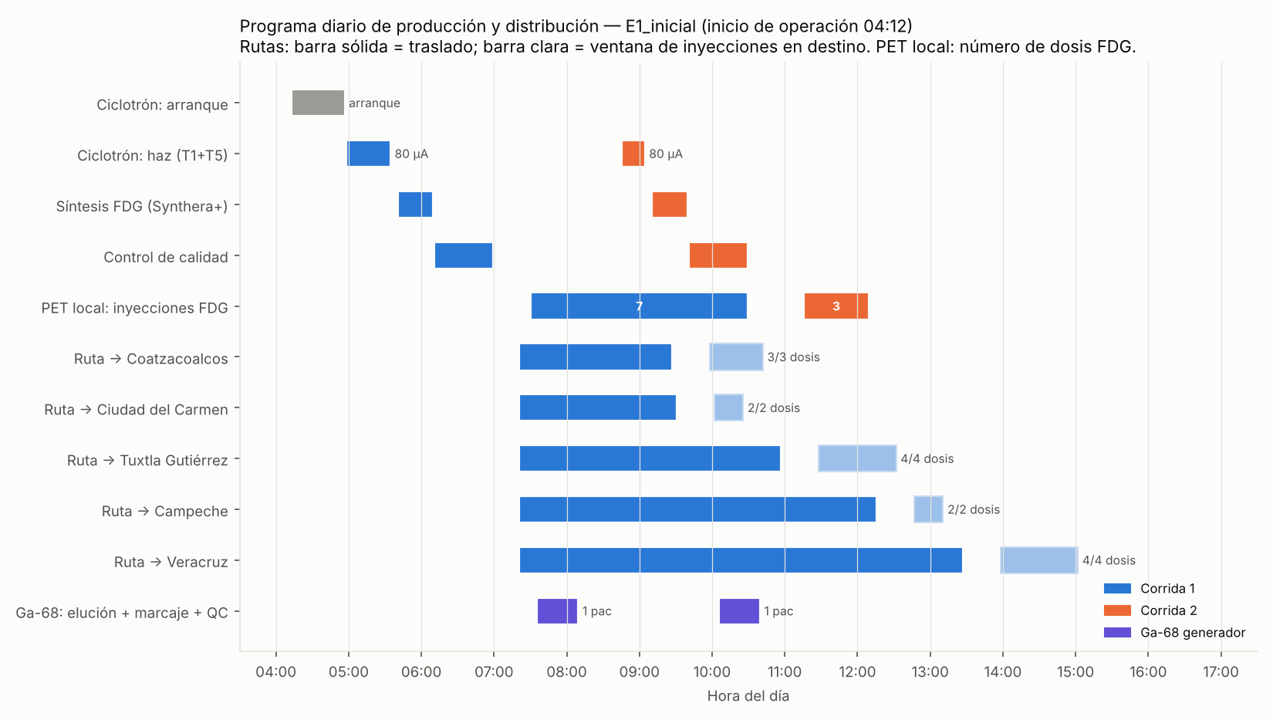
operacion/resultados/gantt_produccion_E1_inicial.png
