plaeyade/Zumaya-AI/operacion/resultados/gantt_produccion_E2_medio.png

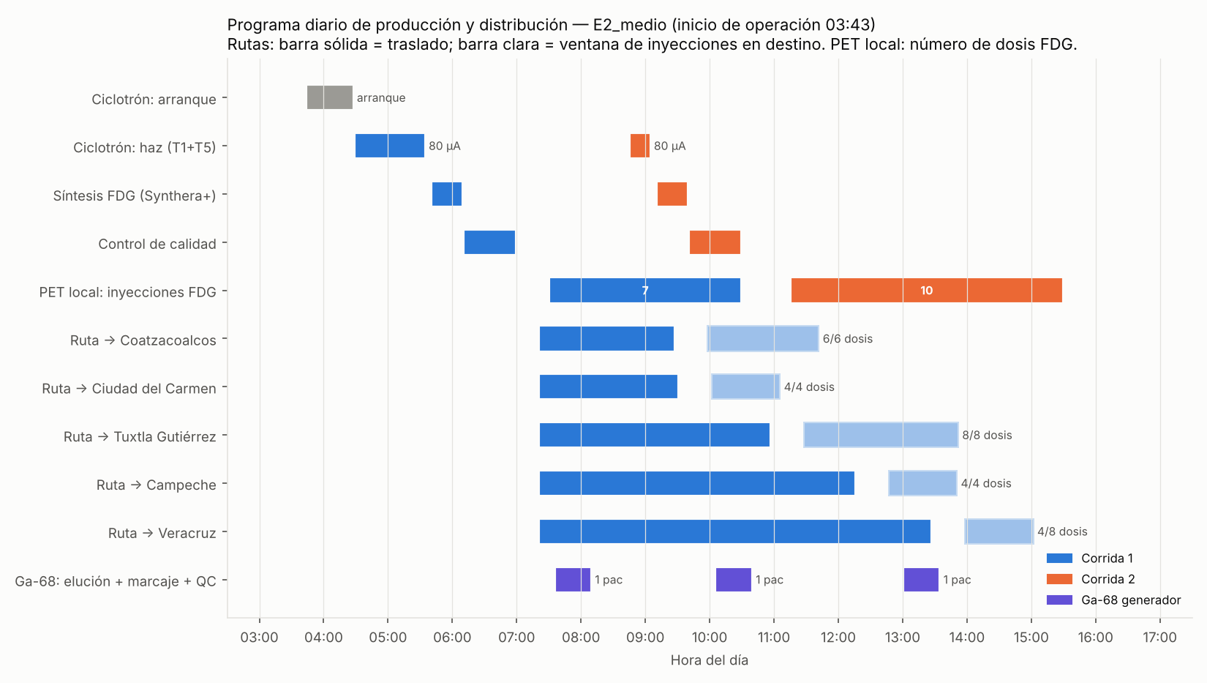
operacion/resultados/gantt_produccion_E2_medio.png
