plaeyade/Zumaya-AI/operacion/resultados/gantt_produccion_E3_maximo.png

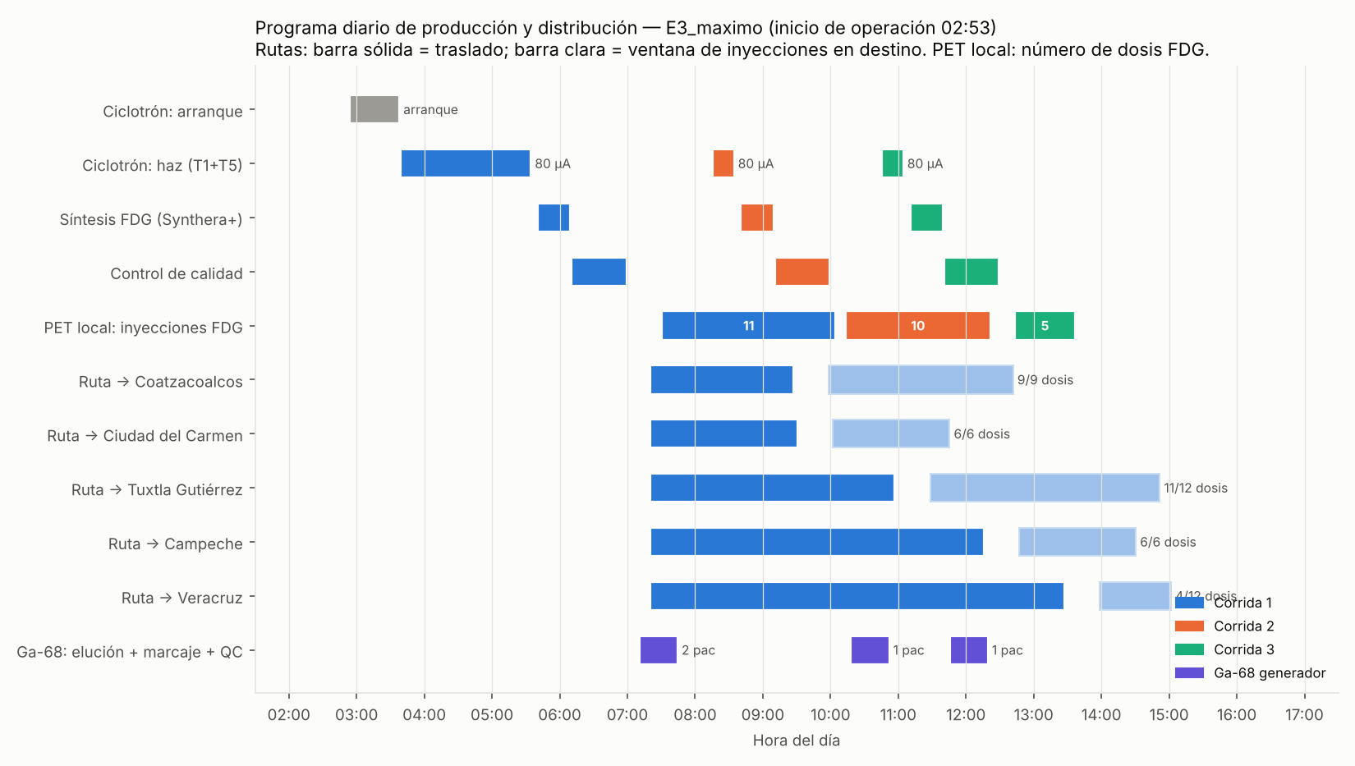
operacion/resultados/gantt_produccion_E3_maximo.png
