plaeyade/Zumaya-AI/operacion/resultados/mapa_factibilidad_distribucion.png

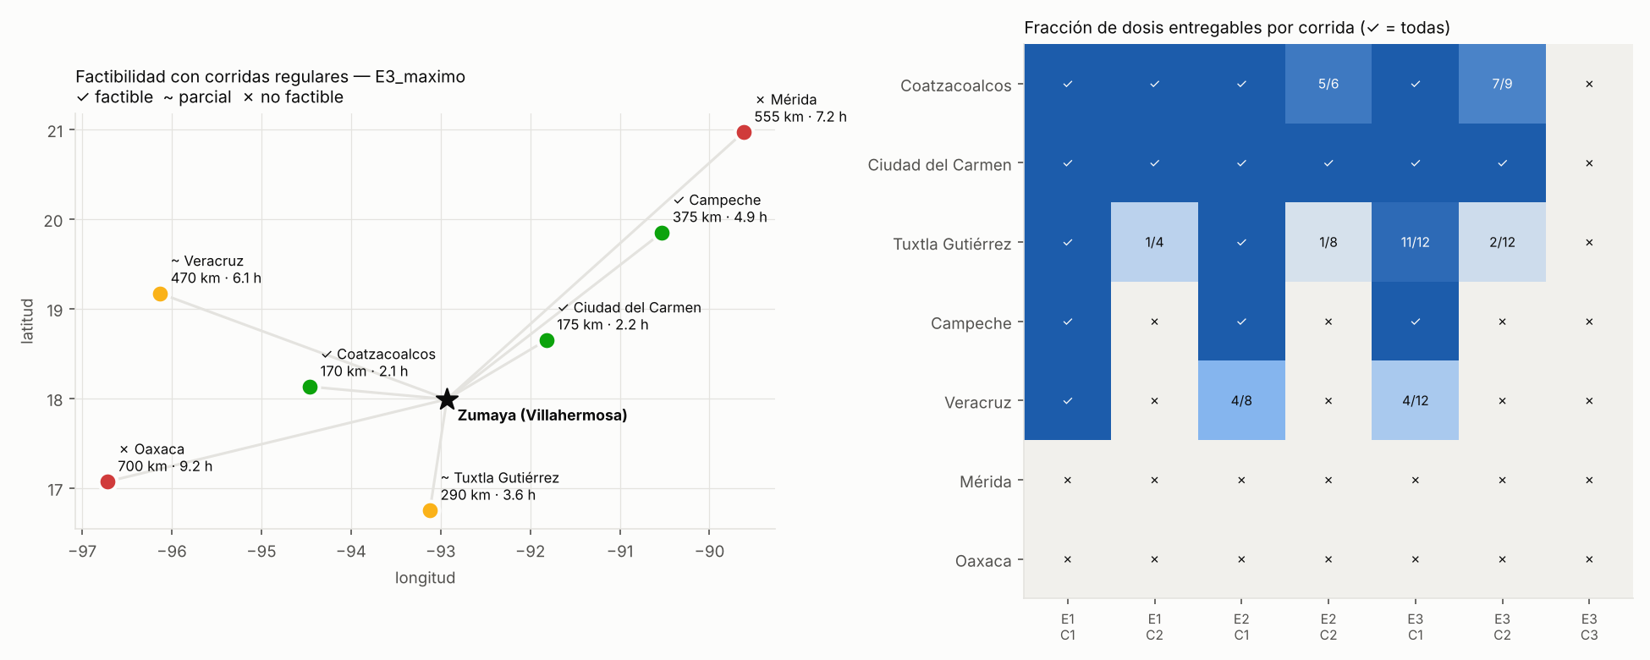
operacion/resultados/mapa_factibilidad_distribucion.png
