plaeyade/Zumaya-AI/operacion/resultados/utilizacion_por_area.png

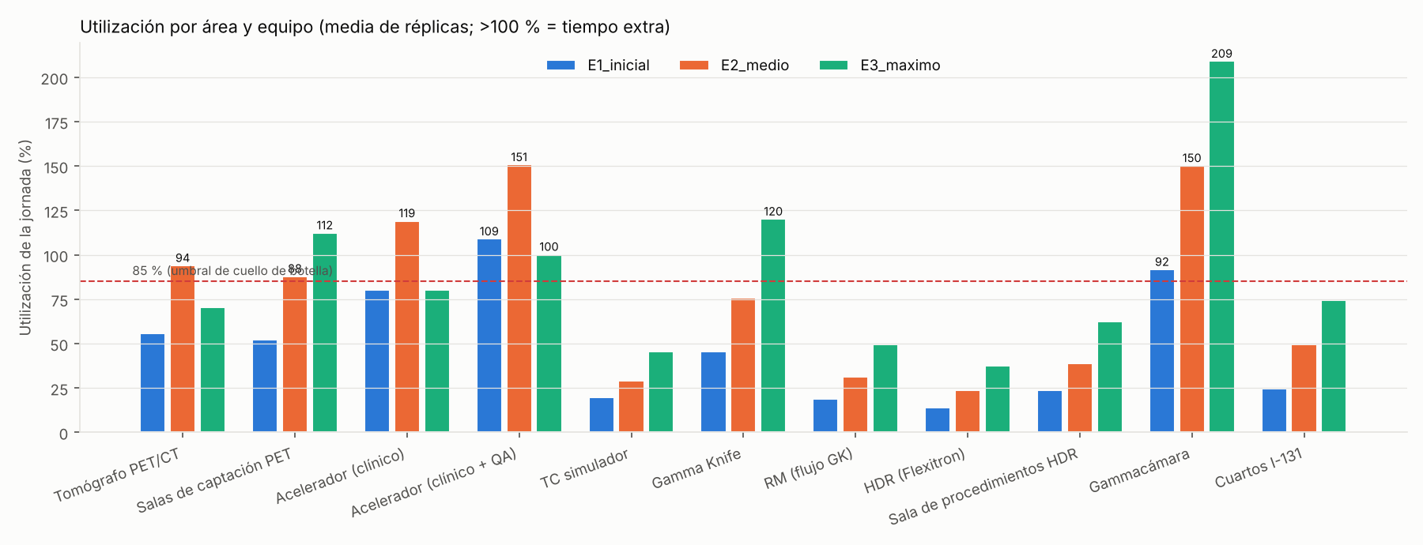
operacion/resultados/utilizacion_por_area.png
