plaeyade/Zumaya-AI/(commit log)

2026-10-31 Zumaya-AI: blindajes F86–F89, fuentes del proyecto (LFS), análisis de planos, MC del ciclotrón, informes
    Claude-Session: https://claude.ai/code/session_01UsuNxxGDpmcCyJTGFRkq7k
    [Linac_TD550_cumplimiento.xlsx, PLANTAS_ARQ_BIND_28-10-26.dwg, PLANTA_BAJA_ARQ_31-10-26.dwg, iba_config.txt]
2026-11-01 F90: validación MC contra IBA SRG tabla 9, doble haz por cara (E 2.08 / O 1.95 / S 2.08 / techo 2.08 m tabique 2.5), cargas actualizadas, informe PDF F90, seguimiento
    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
    [Seguimiento_Zumaya_31-10-26.xlsx]
2026-11-01 Manifiesto gamma/ingesta@1 de las fuentes (ADR-0034 de GAMMA-AI)
    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
2026-11-01 Fases F81–F83 de Zumaya trasladadas desde RadioPharma OS; F82/F83 leen fuentes/ versionadas
    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
2026-11-01 README: objetivos, contratos, estado al 01-11 (espesores F90 interinos, ventilación), ejecución y relación con el ecosistema (#1)
    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
2026-11-08 Modelo operacional: producción del ciclotrón, distribución regional, flujos SimPy y cargas vs blindaje (#5)
    - operacion/modelo.py: plan diario FDG (Ysat calibrado con IBA 24 Ci/2 h/180 uA), Ga-68 (generador y
    blanco líquido), Cu-64; factibilidad de distribución a 7 ciudades; DES SimPy de PET, linac+TC, GK,
    HDR, gammacámara e I-131; mínimos de salas/vestidores/asientos; personal (razones OIEA);
    cargas semanales vs supuestos del blindaje (W 900 Gy/sem, TG-108, I-131).
    - operacion/escenarios.yaml: parámetros con origen [IBA]/[BD]/[LIT]/[SUP].
    - operacion/test_modelo.py: 13 pruebas de decaimiento, producción y entrega.
    - operacion/resultados/: CSV y PNG (Gantt, mapa de factibilida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
    [cargas_vs_diseno_blindaje.csv, corrida_dedicada_por_ciudad.csv, esperas_y_tiempo_extra.csv, factibilidad_distribucion.csv, minimos_recursos.csv, personal.csv, produccion_corridas.csv, sensibilidad_inicio_operacion.csv]
